Allen-Mikhailov/FluiCube/presentation.pptx

## FluiCube

Allen Mikhailov

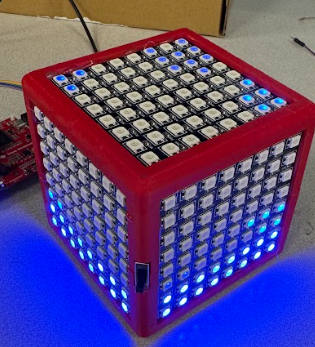
[picture p1: figure]

## Inspiration

https://www.youtube.com/watch?v=jis1MC5Tm8k

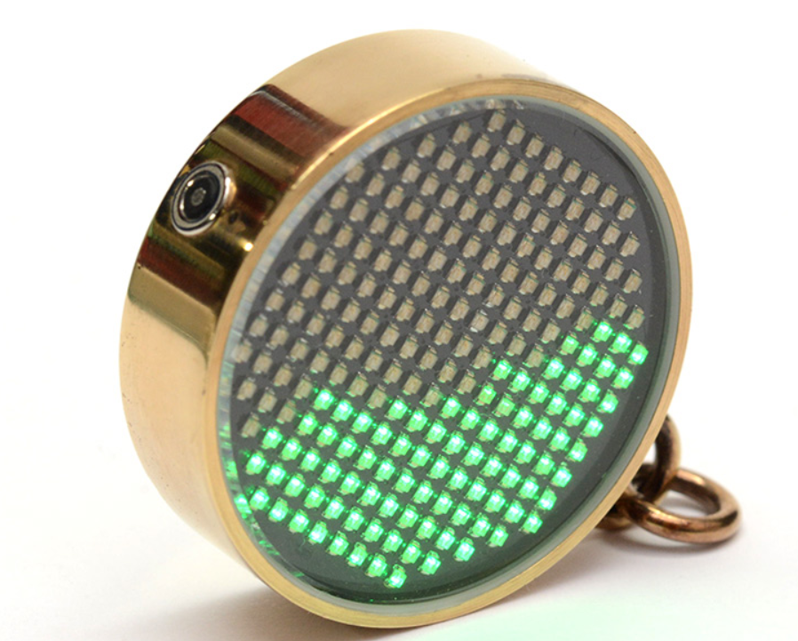
[picture p2: figure]

Past Project

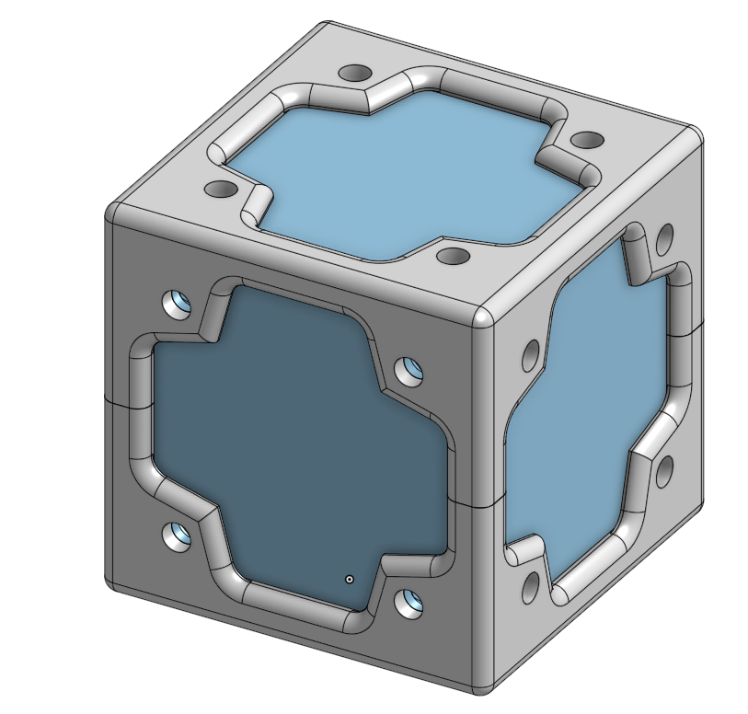
[picture p3: figure]

## Simulation

There are around 30 particles that all repel each other simulated by the processor. The gravity inflicted on the particles in based on the accelerometer. The particles will light up the leds around them on each face with an intensity of how close they are to that face.

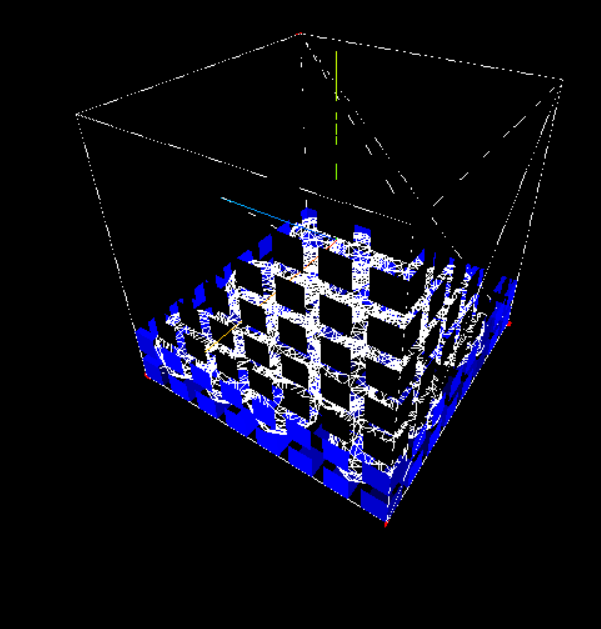
[picture p4: figure]

## Electronics

The electronics are relatively simple.
The Lights are made up of 6 neopixel 8x8 led grids connected in series
The microprocessor communicates to the accelerometer through SPI while the neopixels are controller by the PICO of the other SPI bus.
Everything is powered by a 3.3V battery
pack which is distributed by a perfboard

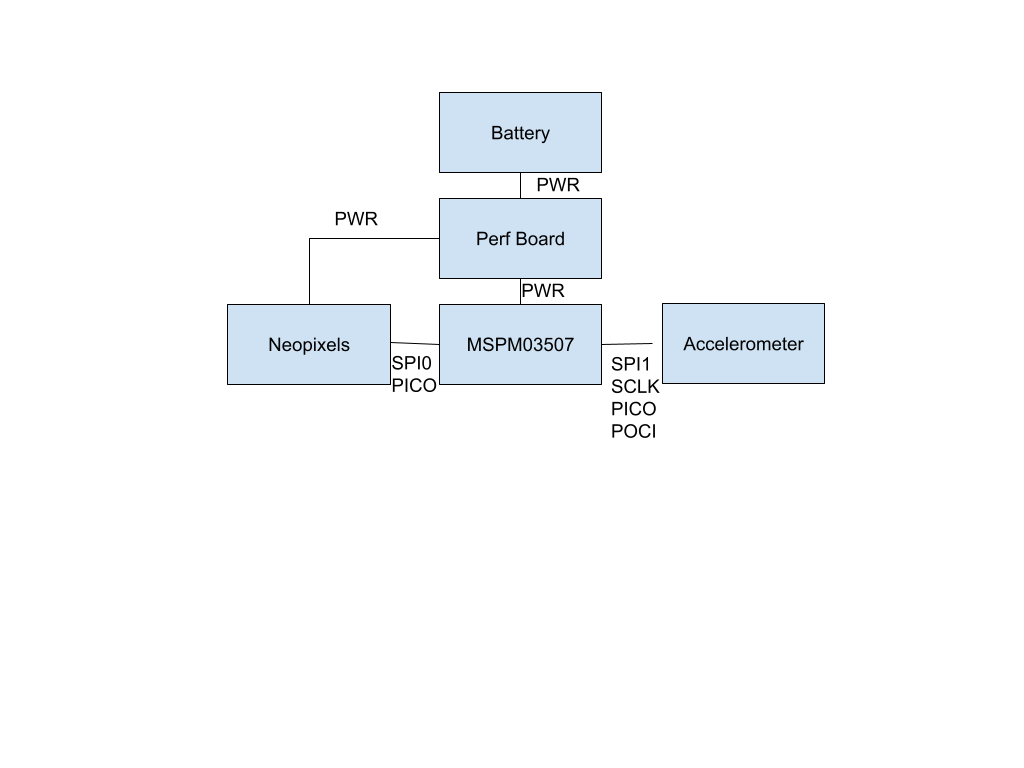
[picture p5: figure]

## Mechanical

The frame is split into a top and bottom half. They use a male-female interlock to connect. The bottom half has a place for the battery to sit. The simon board and perf board sit on the edges. Everything is hot glued on.

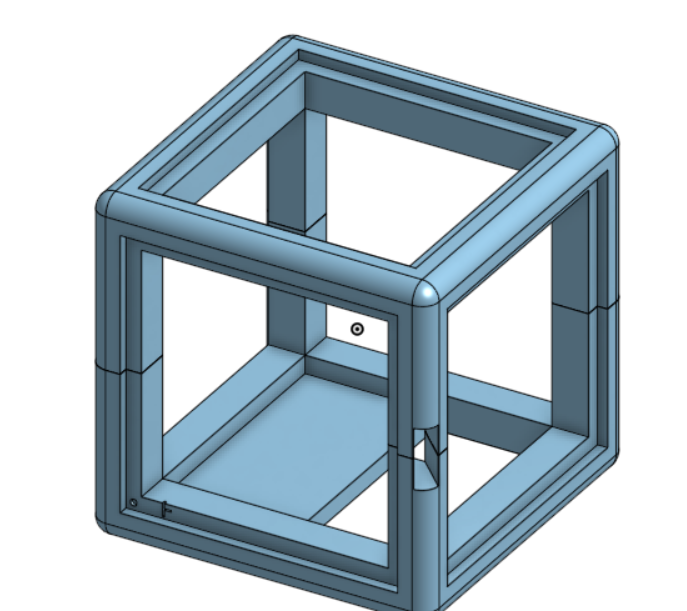
[picture p6: figure]
