Allen-Mikhailov/FluiCube/CAD/Flui-Cube - Part 2.stl

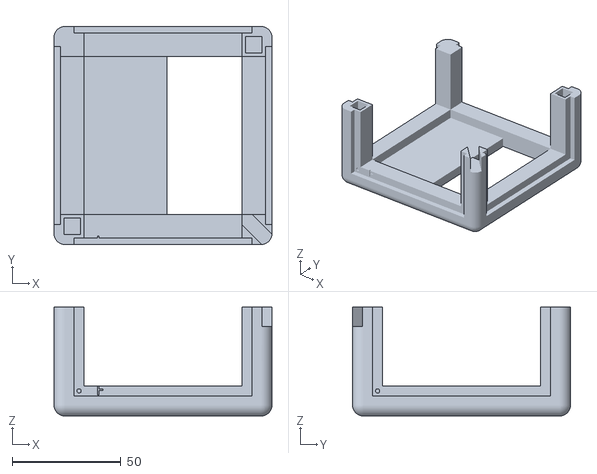
[picture p12: CAD file, 2025-05-08]
CAD/Flui-Cube - Part 2.stl
100.0 x 100.0 x 50.0
