Allen-Mikhailov/FluiCube/CAD/Flui-Cube - Part 3.stl

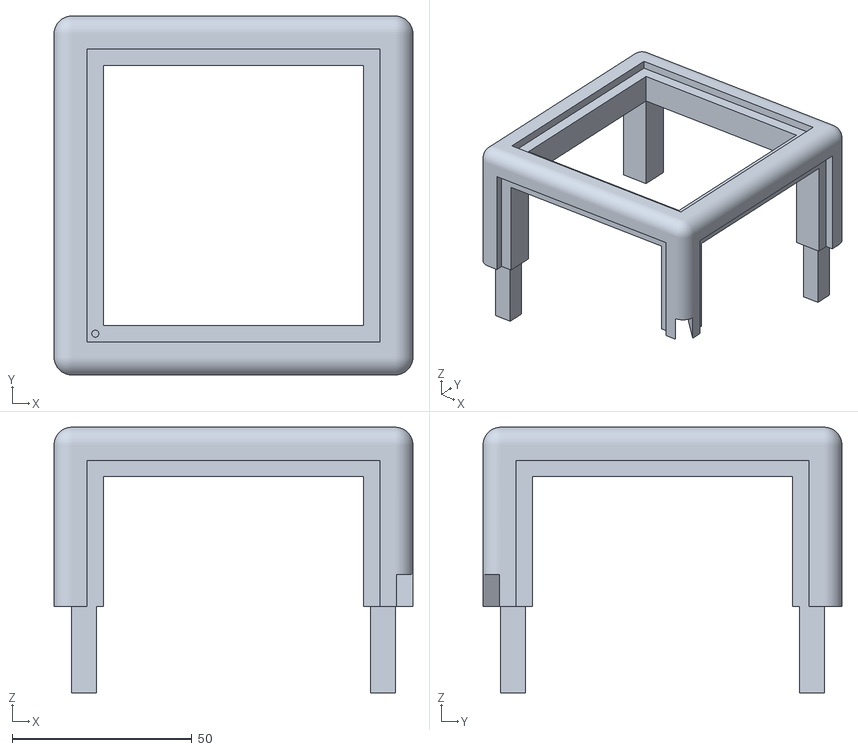
[picture p13: CAD file, 2025-05-08]
CAD/Flui-Cube - Part 3.stl
100.0 x 100.0 x 74.0
