Allen-Mikhailov/FluiCube/327_project_pcb/327_project_pcb.kicad_pcb

## KiCad design 327_project_pcb/327_project_pcb.kicad_pcb (2025-05-08)

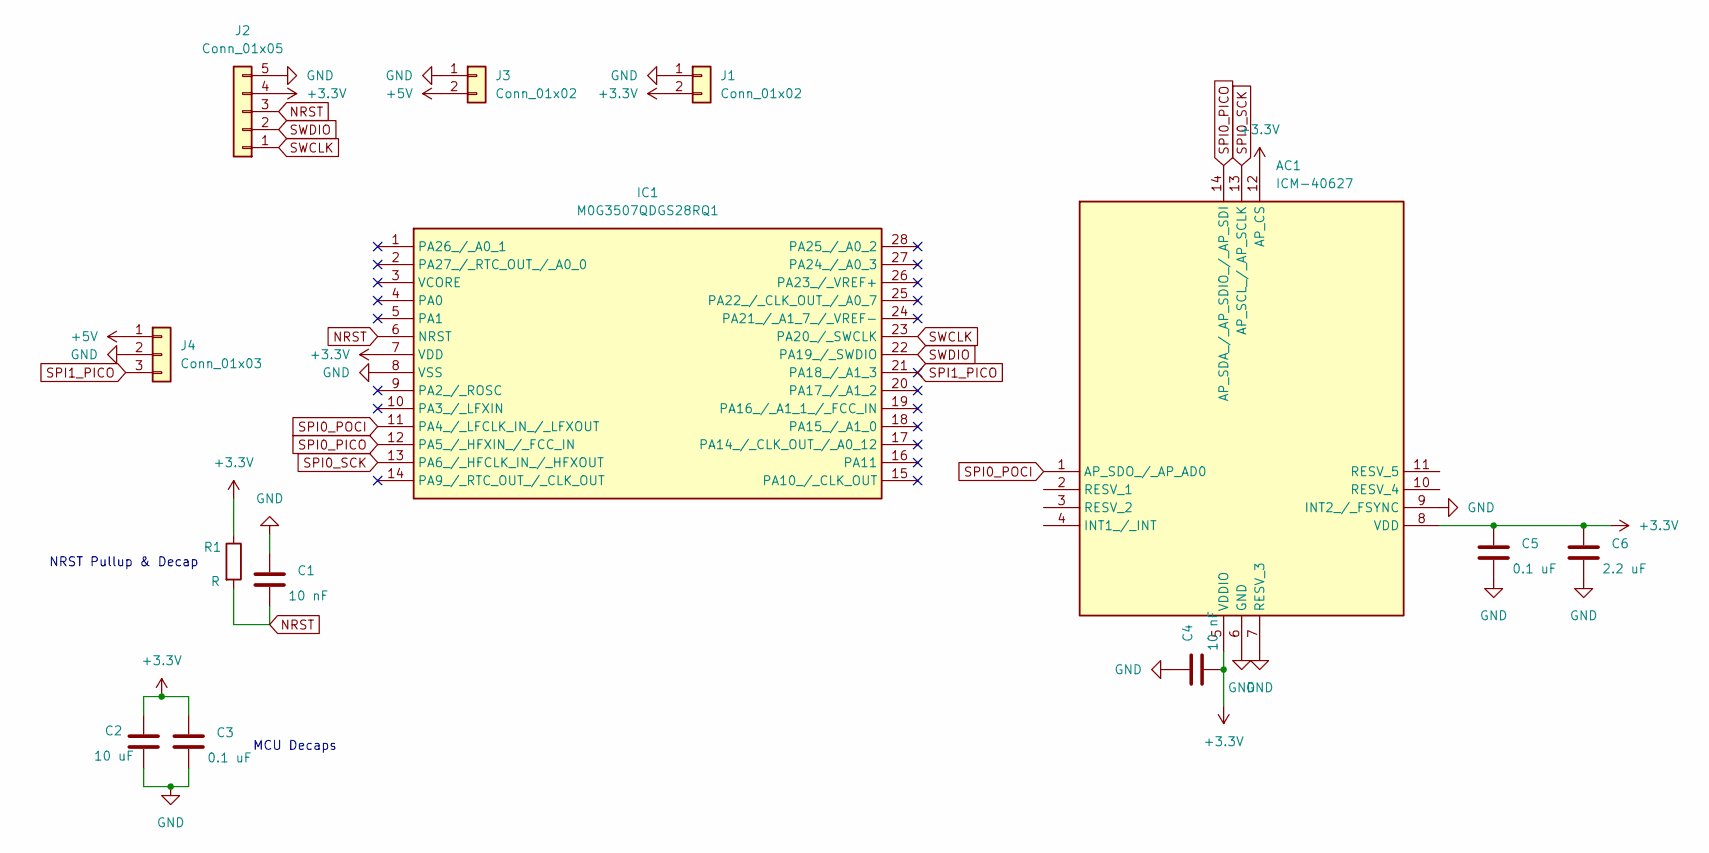
[picture p14: schematic 327_project_pcb.kicad_sch]

Parts:
AC1: ICM-40627; IIM42352; Manufacturer_Part_Number ICM-40627; Mouser Part Number 410-ICM-40627
C1: 10 nF; C_0805_2012Metric_Pad1.18x1.45mm_HandSolder
C2: 10 uF; C_1210_3225Metric_Pad1.33x2.70mm_HandSolder
C3: 0.1 uF; C_0805_2012Metric_Pad1.18x1.45mm_HandSolder
C4: 10 nF; CP_Radial_D5.0mm_P2.50mm
C5: 0.1 uF; CP_Radial_D4.0mm_P2.00mm
C6: 2.2 uF; CP_Radial_D4.0mm_P2.00mm
IC1: M0G3507QDGS28RQ1; SOP50P490X110-28N; Manufacturer_Part_Number M0G3507QDGS28RQ1; Mouser Part Number 595-M0G3507QDGS28RQ1
J1, J3: Conn_01x02; PinHeader_1x02_P2.54mm_Vertical
J2: Conn_01x05; PinHeader_1x05_P2.54mm_Horizontal
J4: Conn_01x03; PinHeader_1x03_P2.54mm_Vertical
R1: R; R_0805_2012Metric_Pad1.20x1.40mm_HandSolder

Connections:
+3.3V: AC1.5 (VDDIO), AC1.8 (VDD), AC1.12 (AP_CS), C2.1, C3.1, C4.2, C5.1, C6.1, IC1.7 (VDD), J1.2, J2.4, R1.1
+5V: J3.2, J4.1
GND: AC1.6 (GND), AC1.7 (RESV_3), AC1.9 (INT2_/_FSYNC), C1.1, C2.2, C3.2, C4.1, C5.2, C6.2, IC1.8 (VSS), J1.1, J2.5, J3.1, J4.2
NRST: C1.2, IC1.6 (NRST), J2.3, R1.2
SPI0_PICO: AC1.14 (AP_SDA_/_AP_SDIO_/_AP_SDI), IC1.12 (PA5_/_HFXIN_/_FCC_IN)
SPI0_POCI: AC1.1 (AP_SDO_/_AP_AD0), IC1.11 (PA4_/_LFCLK_IN_/_LFXOUT)
SPI0_SCK: AC1.13 (AP_SCL_/_AP_SCLK), IC1.13 (PA6_/_HFCLK_IN_/_HFXOUT)
SPI1_PICO: IC1.21 (PA18_/_A1_3), J4.3
SWCLK: IC1.23 (PA20_/_SWCLK), J2.1
SWDIO: IC1.22 (PA19_/_SWDIO), J2.2

Notes on the sheet:
NRST Pullup & Decap
MCU Decaps

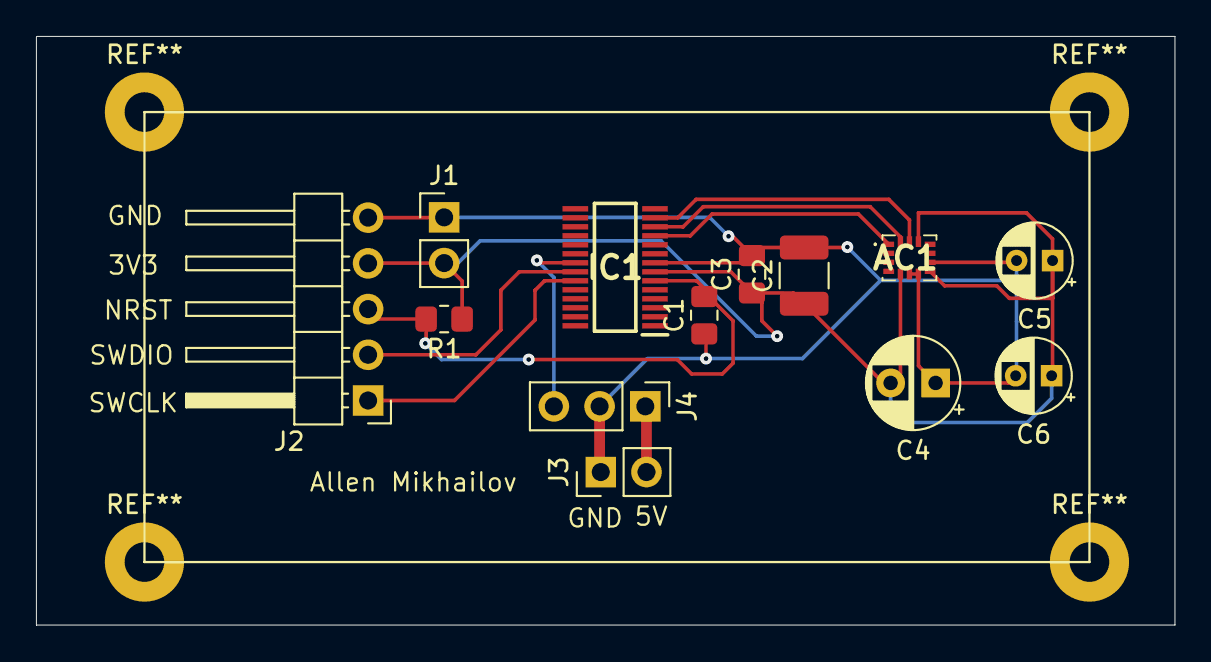
[picture p15: board 327_project_pcb.kicad_pcb from above]

Board: 2 copper layers, 63.2 x 32.7 mm, 13 parts (0 on the bottom side), 10 nets.
