Allen-Mikhailov/FluiCube/(commit log)

2025-05-08 Inital Transfer from private elec 327 repo
    [327_project_pcb-B_Cu.gbr, 327_project_pcb-B_Mask.gbr, 327_project_pcb-B_Paste.gbr, 327_project_pcb-B_Silkscreen.gbr, 327_project_pcb-Edge_Cuts.gbr, 327_project_pcb-F_Cu.gbr, 327_project_pcb-F_Mask.gbr, 327_project_pcb-F_Paste.gbr]
2025-05-08 Added extra files
    [Flui-Cube - Part 2.stl, Flui-Cube - Part 3.stl]
2025-07-23 Fixed some issues with the code around orientation and startup, also reverted back to just blue
    [main.c, simulation.c]
